0Londero/H.I.D.E-Hardware-Input-Dynamic-Emulator/firmware/firmware.ino

// Sketch H.I.D.E (firmware do Pico).
// O código está no arquivo firmware.cpp, nesta mesma pasta.
// Para usar: abra esta pasta no Arduino IDE e configure:
//   Tools > USB Stack  = "Adafruit TinyUSB"
//   Tools > CPU Speed  = 240 MHz
// Depois compile e envie.
