0Londero/H.I.D.E-Hardware-Input-Dynamic-Emulator/(commit log)

2026-11-04 docs: organize profiles folder and reword Teensy paragraph
2026-11-04 docs: add wiring diagram to montagem section
2026-11-04 docs: add breadboard and schematic images to assembly section
2026-11-06 docs: clarify Arduino IDE setup (UF2 port, deps, ArduinoJson v6)
2026-11-07 docs: note 8-byte mouse limitation and track PR #206
2026-11-07 docs: simplify mouse wording and generalize 500 Hz guidance
2026-11-08 docs: note Razer 8-byte mice unsupported; rename test sketch to teste_mouse
    - Rename teste_dongle -> teste_mouse (general mouse test sketch)
    - README/TODO: Razer mice (8-byte reports) stop responding on PIO-USB, no known fix
    [teste_mouse.ino]
